adithya-in/tankguard/(commit log)

2026-10-18 Initial commit: TankGuard patent disclosure, proposals, and BOM
2026-10-26 Add technical specification PDF and update patent disclosure
    - New TankGuard_Specification.pdf (8 sections: title, abstract, components,
    features, uniqueness, cost, HW/SW specs, 4 drawings)
    - Update patent disclosure with IoT focus, component BOM, how-it-works,
    trim sections 11-12
    - README: list specification document
2026-10-29 Add home-side module (H1) hardware guide for pump automation
2026-10-29 Home module: use ST7735 TFT and flush/motor override buttons
2026-10-29 Add H1 ESP8266 firmware (ST7735, relay, flush/motor buttons)
2026-10-29 Add tank-side firmware (ADS1115 sensors, valve, HTTP API)
2026-10-30 Add nRF24L01+ long-range link design and pin remap
2026-10-30 Remove solenoid flush valve; refocus on monitoring and safe pump control
2026-10-31 Document 2-arm BTS7960 PWM pin remap
2026-10-31 Implement two-arm BTS7960 PWM control
